BYU-ELC/191_SolarTracker/Mini_Pan_Tilt_-_Servo_G9/images/2015-03-04_19.35.58_preview_featured.jpg

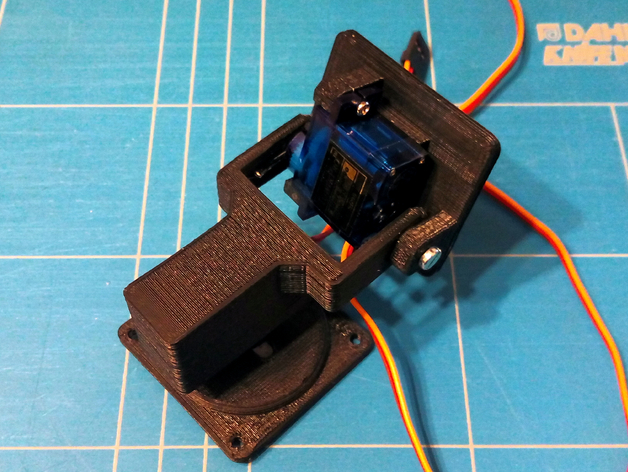
Mini_Pan_Tilt_-_Servo_G9/images/2015-03-04_19.35.58_preview_featured.jpg
