BYU-ELC/191_SolarTracker/README.md

# 191_SolarTracker
This repo has code, files, schematics, and other information for the BYU 191 Solar Tracking project based on GreatScott: https://www.youtube.com/watch?v=_6QIutZfsFs.
