BYU-ELC/191_SolarTracker/Mobius+Pan+&+Tilt+with+9gram+servos/README.txt

Mobius Pan & Tilt with 9gram servos by blister on Thingiverse: https://www.thingiverse.com/thing:1401116
