BYU-ELC/191_SolarTracker/Mini_Pan_Tilt_-_Servo_G9/images/Pan-tilt-plataforma_preview_featured.jpg

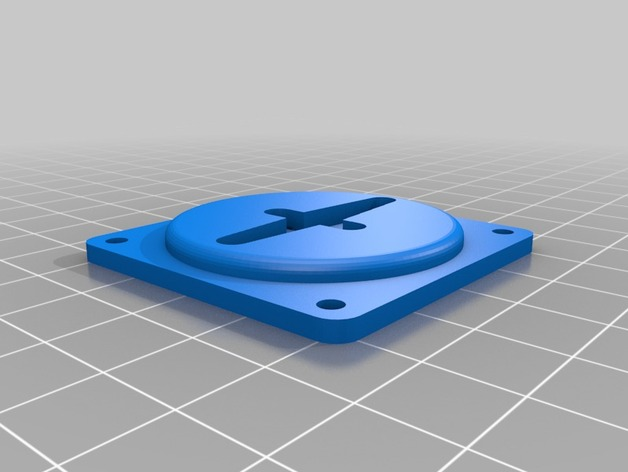
Mini_Pan_Tilt_-_Servo_G9/images/Pan-tilt-plataforma_preview_featured.jpg
