BYU-ELC/191_SolarTracker/Mobius+Pan+&+Tilt+with+9gram+servos/images/0caf233689d26366a17ab7eb2f63b619.png

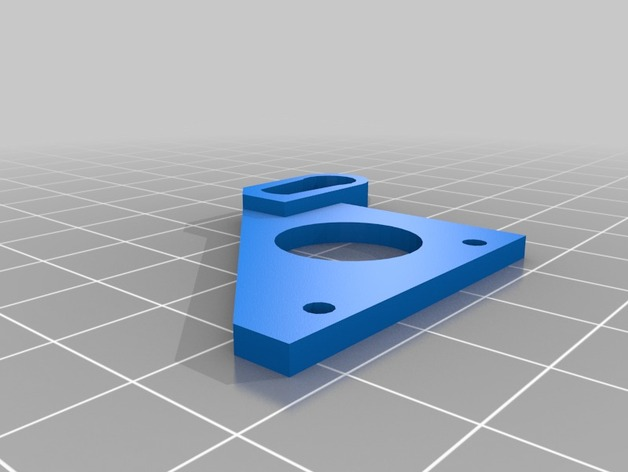
Mobius+Pan+&+Tilt+with+9gram+servos/images/0caf233689d26366a17ab7eb2f63b619.png
