BYU-ELC/191_SolarTracker/Mobius+Pan+&+Tilt+with+9gram+servos/images/03b6a9fba97699c6382648f625db19b3.png

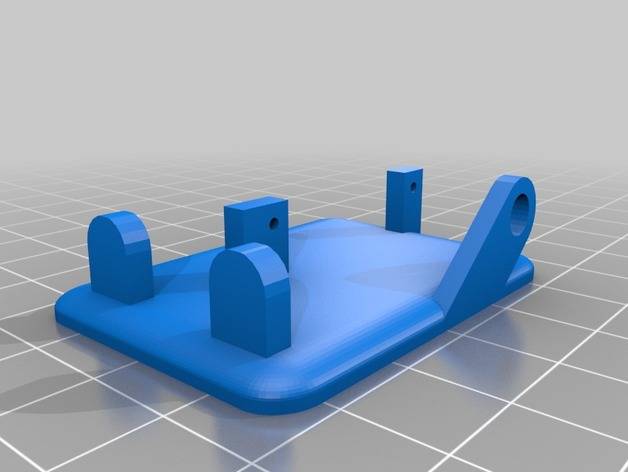
Mobius+Pan+&+Tilt+with+9gram+servos/images/03b6a9fba97699c6382648f625db19b3.png
