BYU-ELC/191_SolarTracker/Mobius+Pan+&+Tilt+with+9gram+servos/images/57f312213586f4db5ce062b65d8a6737.png

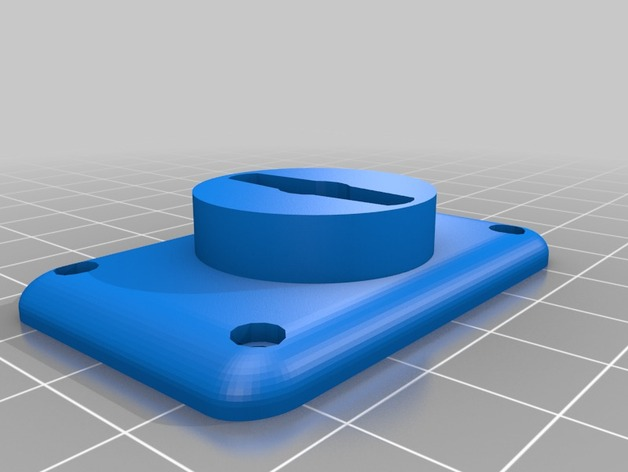
Mobius+Pan+&+Tilt+with+9gram+servos/images/57f312213586f4db5ce062b65d8a6737.png
