BYU-ELC/191_SolarTracker/Mobius+Pan+&+Tilt+with+9gram+servos/images/9785df5b3c4bcc21102b424c023c74ee.png

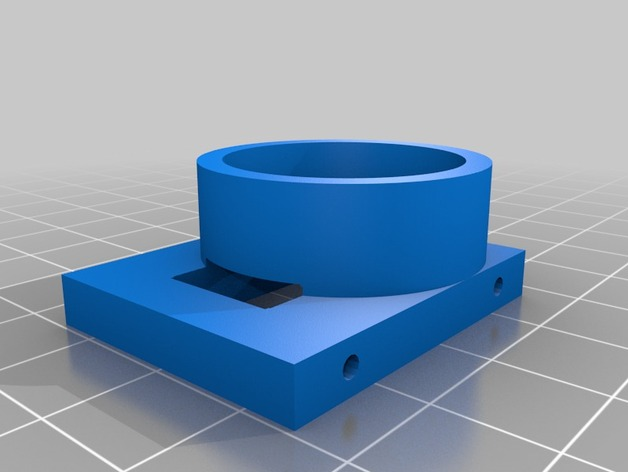
Mobius+Pan+&+Tilt+with+9gram+servos/images/9785df5b3c4bcc21102b424c023c74ee.png
