BYU-ELC/191_SolarTracker/Mobius+Pan+&+Tilt+with+9gram+servos/images/Bix6.jpg

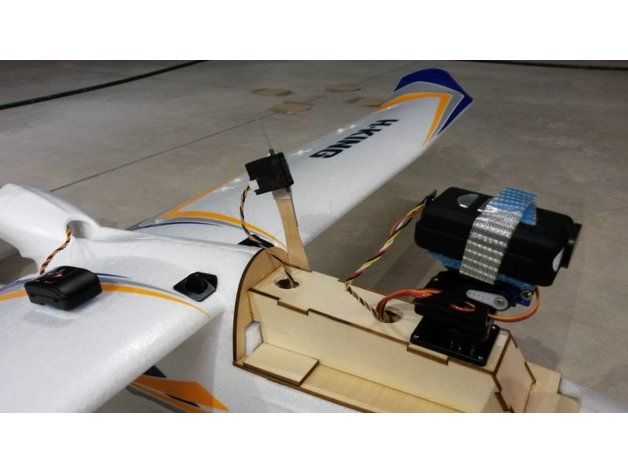
Mobius+Pan+&+Tilt+with+9gram+servos/images/Bix6.jpg
