BYU-ELC/191_SolarTracker/Mobius+Pan+&+Tilt+with+9gram+servos/images/c6f291fa60999e65766b35e9e83c47e5.png

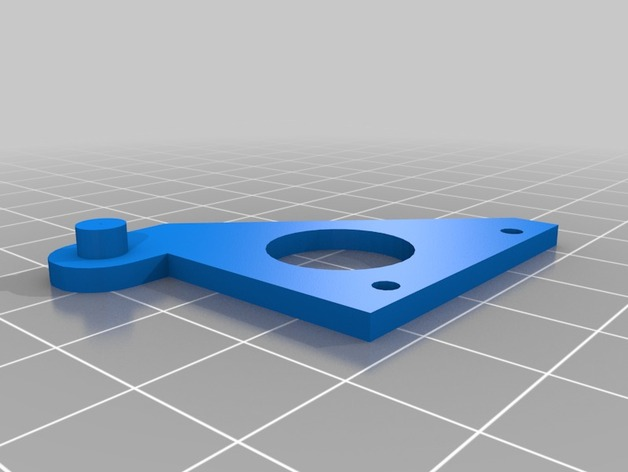
Mobius+Pan+&+Tilt+with+9gram+servos/images/c6f291fa60999e65766b35e9e83c47e5.png
