BYU-ELC/191_SolarTracker/Mobius+Pan+&+Tilt+with+9gram+servos/images/Fletts_08Jan2015__03.png

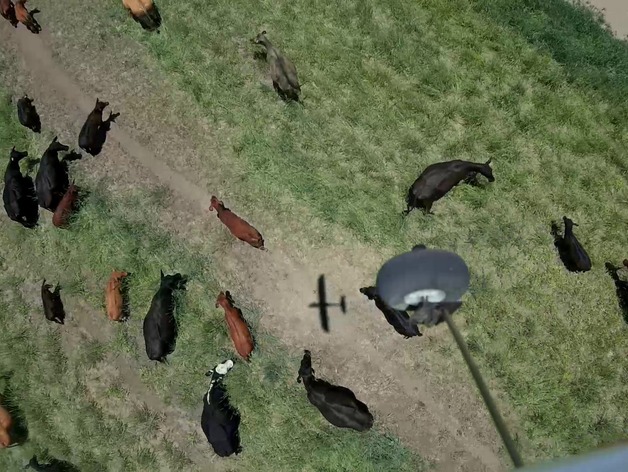
Mobius+Pan+&+Tilt+with+9gram+servos/images/Fletts_08Jan2015__03.png
