BYU-ELC/191_SolarTracker/Mobius+Pan+&+Tilt+with+9gram+servos/images/PanTilt3.jpg

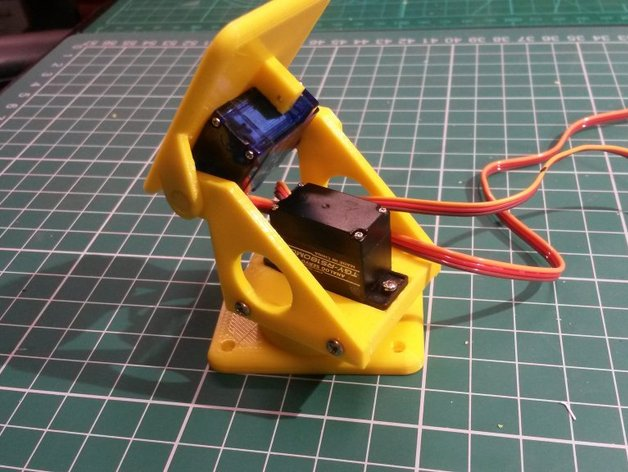
Mobius+Pan+&+Tilt+with+9gram+servos/images/PanTilt3.jpg
