BYU-ELC/191_SolarTracker/Mobius+Pan+&+Tilt+with+9gram+servos/images/vlcsnap-2016-05-17-20h27m01s989.png

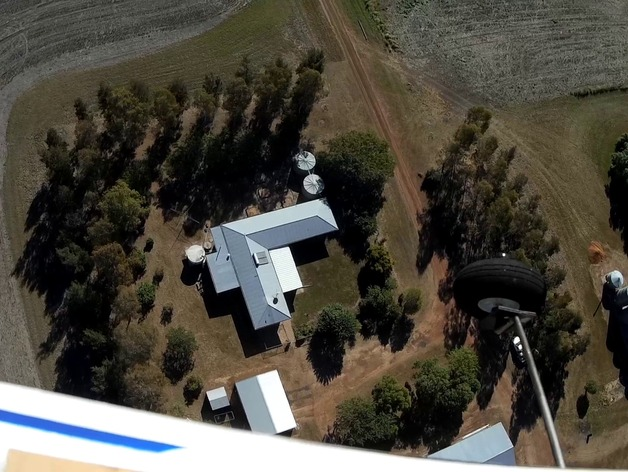
Mobius+Pan+&+Tilt+with+9gram+servos/images/vlcsnap-2016-05-17-20h27m01s989.png
