BYU-ELC/191_SolarTracker/Mini_Pan_Tilt_-_Servo_G9/files/Pan-tilt-tapa.stl

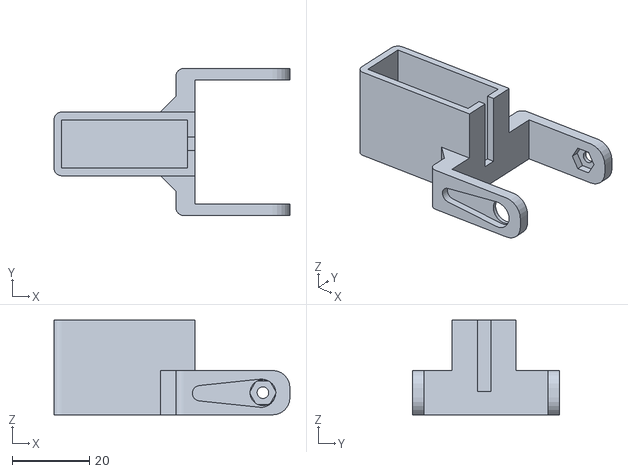
[picture p22: CAD file, 2021-06-09]
Mini_Pan_Tilt_-_Servo_G9/files/Pan-tilt-tapa.stl
61.0 x 38.0 x 24.5
