BYU-ELC/191_SolarTracker/Mobius+Pan+&+Tilt+with+9gram+servos/files/left.stl

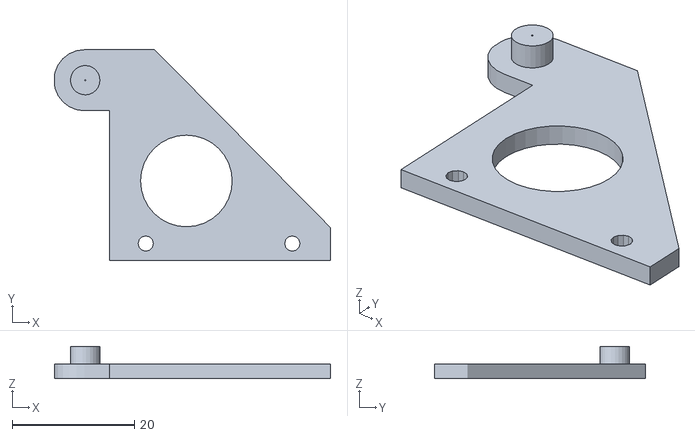
[picture p23: CAD file, 2021-06-09]
Mobius+Pan+&+Tilt+with+9gram+servos/files/left.stl
45.2 x 34.5 x 5.30
