BYU-ELC/191_SolarTracker/SolarTracker.stl

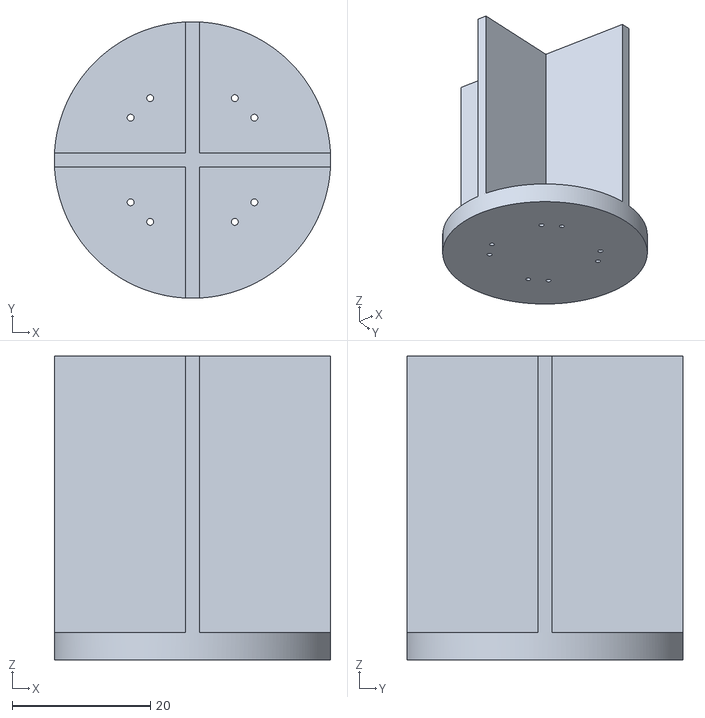
[picture p24: CAD file, 2021-06-09]
SolarTracker.stl
40.0 x 40.0 x 44.0
