BYU-ELC/191_SolarTracker/Mini_Pan_Tilt_-_Servo_G9/files/Pan-tilt-base-camara.stl

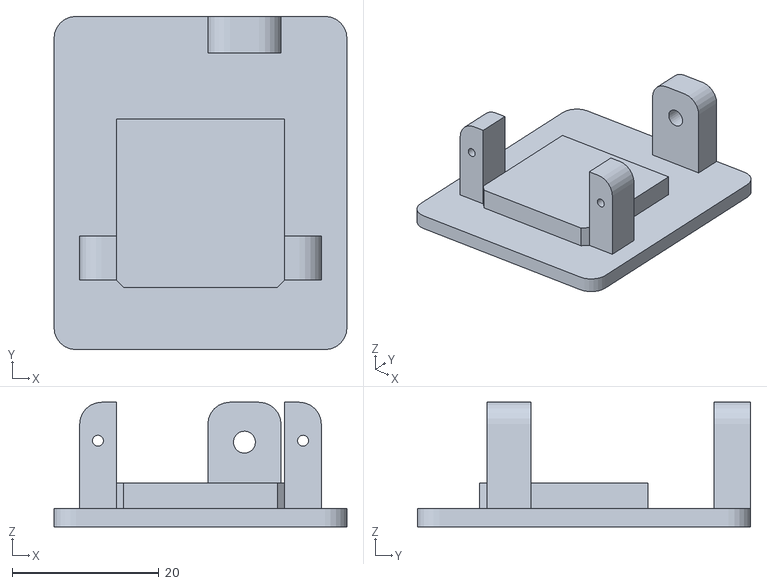
[picture p25: CAD file, 2021-06-09]
Mini_Pan_Tilt_-_Servo_G9/files/Pan-tilt-base-camara.stl
40.0 x 45.5 x 17.0
