BYU-ELC/191_SolarTracker/Mobius+Pan+&+Tilt+with+9gram+servos/files/right.stl

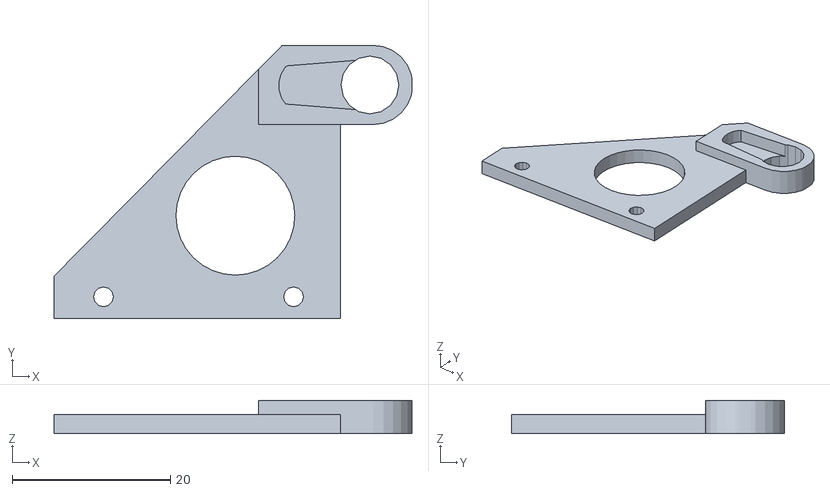
[picture p26: CAD file, 2021-06-09]
Mobius+Pan+&+Tilt+with+9gram+servos/files/right.stl
45.2 x 34.5 x 4.20
