BYU-ELC/191_SolarTracker/Mini_Pan_Tilt_-_Servo_G9/files/all three.stl

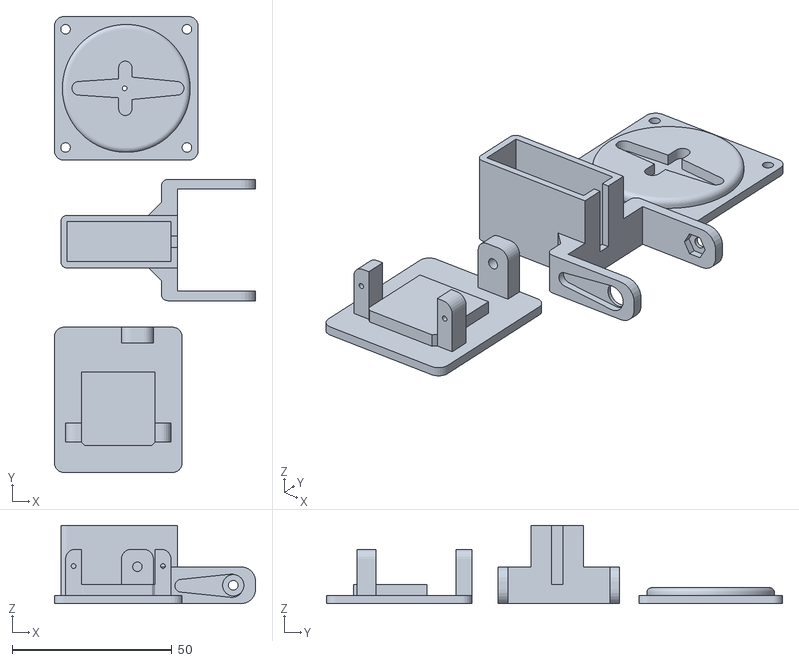
[picture p27: CAD file, 2021-06-09]
Mini_Pan_Tilt_-_Servo_G9/files/all three.stl
63.0 x 142.8 x 24.5
