BYU-ELC/191_SolarTracker/Mobius+Pan+&+Tilt+with+9gram+servos/files/middle.stl

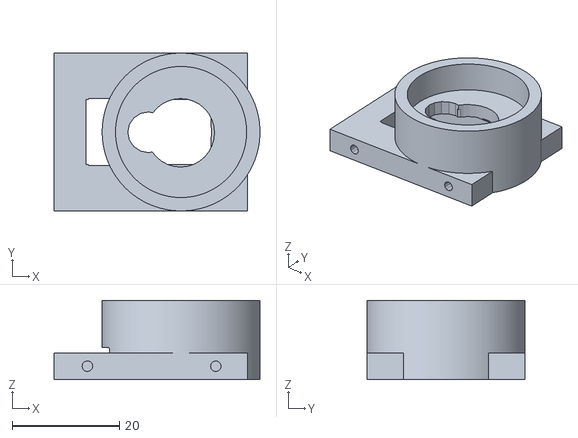
[picture p28: CAD file, 2021-06-09]
Mobius+Pan+&+Tilt+with+9gram+servos/files/middle.stl
38.5 x 29.5 x 14.8
