BYU-ELC/191_SolarTracker/Mini_Pan_Tilt_-_Servo_G9/files/Pan-tilt-plataforma.stl

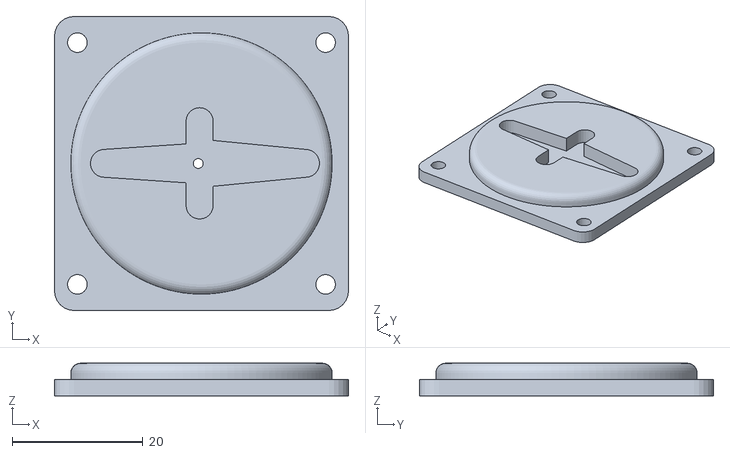
[picture p29: CAD file, 2021-06-09]
Mini_Pan_Tilt_-_Servo_G9/files/Pan-tilt-plataforma.stl
45.0 x 45.0 x 5.00
