BYU-ELC/191_SolarTracker/Mobius+Pan+&+Tilt+with+9gram+servos/files/base.stl

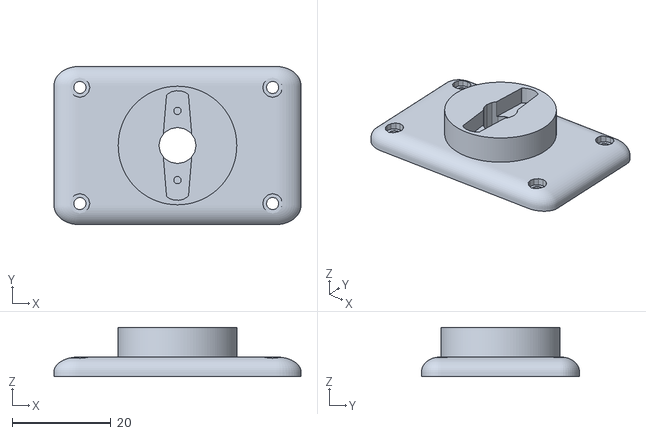
[picture p30: CAD file, 2021-06-09]
Mobius+Pan+&+Tilt+with+9gram+servos/files/base.stl
50.0 x 32.0 x 10.00
