BYU-ELC/191_SolarTracker/Mobius+Pan+&+Tilt+with+9gram+servos/files/top.stl

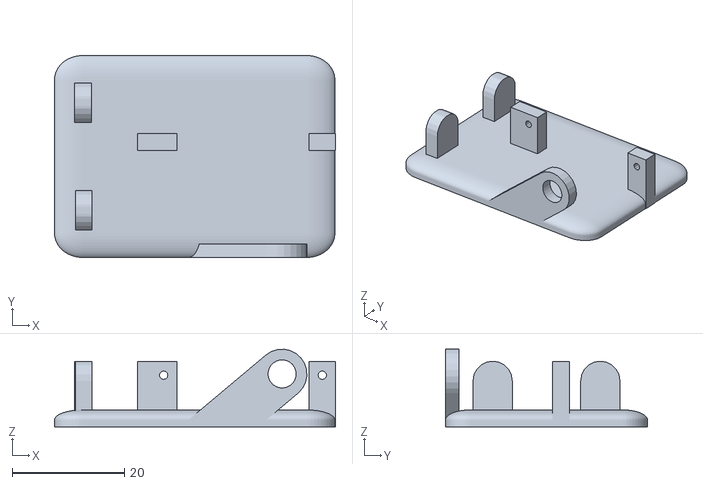
[picture p31: CAD file, 2021-06-09]
Mobius+Pan+&+Tilt+with+9gram+servos/files/top.stl
50.1 x 36.0 x 13.8
