BYU-ELC/191_SolarTracker/(commit log)

2021-06-09 Add files via upload
    These are all of the essential files (along with the parts listed in the ReadMe) to construct the project, though I haven't added any instructions yet.
    [Pan-tilt-base-camara.stl, Pan-tilt-plataforma.stl, Pan-tilt-tapa.stl, SolarTracker.stl, all three.stl, base.stl, left.stl, middle.stl]
2021-08-30 Add files via upload
    Added the 3 Arduino files
